Abdelrahman44/autonomous-robot/snapshot00.png

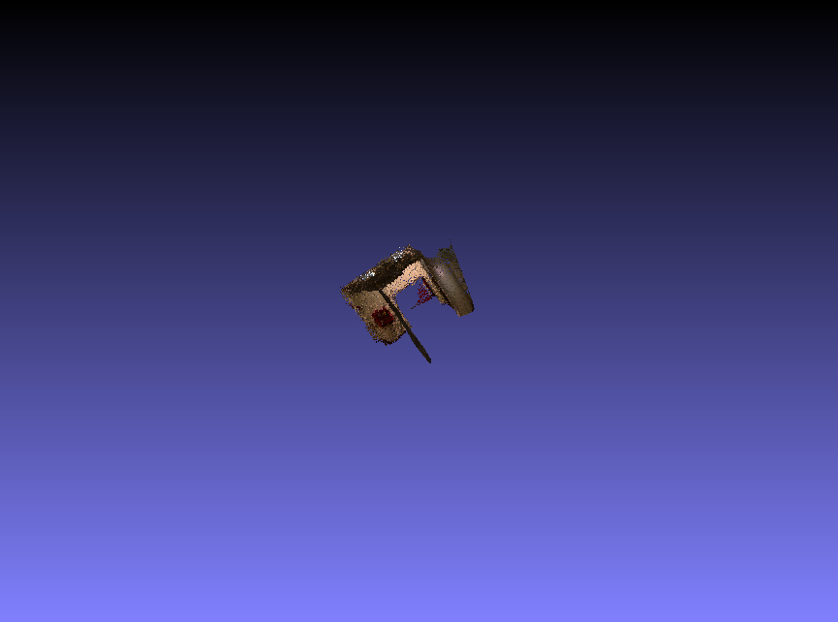
snapshot00.png
