Abdelrahman44/autonomous-robot/snapshot200.png

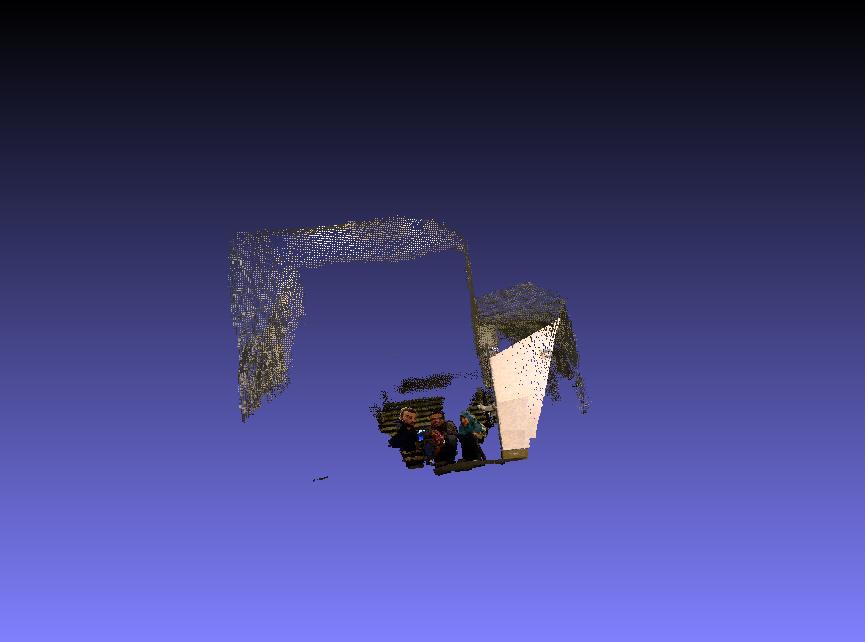
snapshot200.png
