Abdelrahman44/autonomous-robot/README.md

# autonomous-robot

A robot built using ROS to navigate and map the environment using Kinect and ultra sonic sensors. Ardunio codes and integration with ROS are included
