Abdelrahman44/autonomous-robot/Selection_001.png

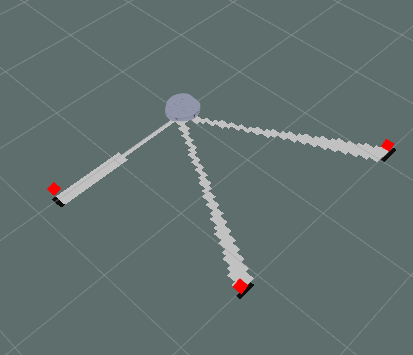
Selection_001.png
