Abdelrahman44/autonomous-robot/Hexabot/meshes/BackCastor.STL

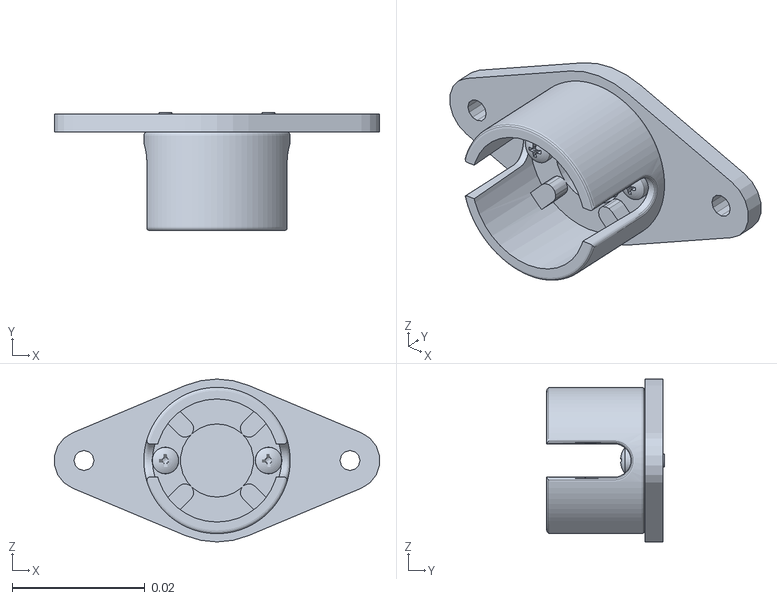
[picture p16: CAD file, 2020-01-17]
Hexabot/meshes/BackCastor.STL
0.0489 x 0.0177 x 0.0245
