Abdelrahman44/autonomous-robot/Hexabot/robots/include/RightWheel.STL

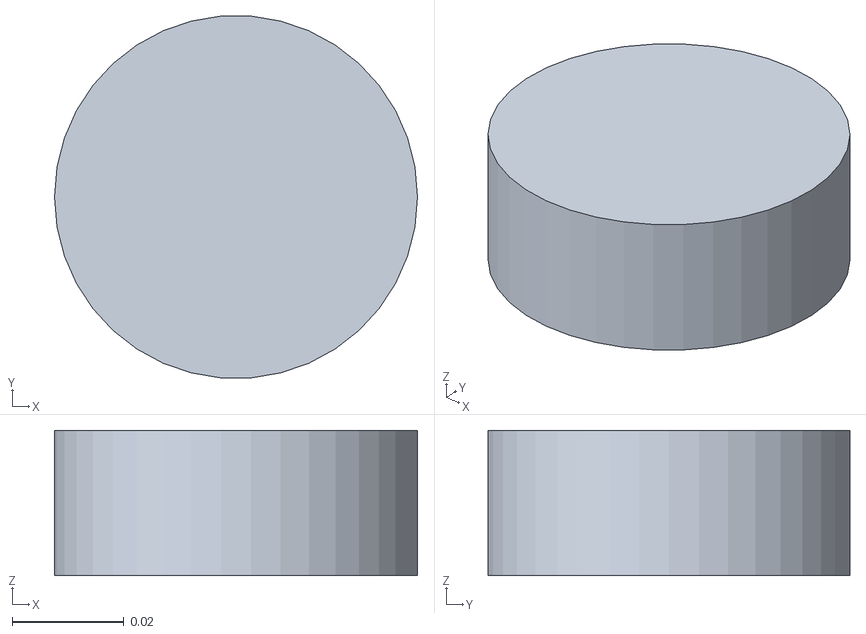
[picture p17: CAD file, 2020-01-17]
Hexabot/robots/include/RightWheel.STL
0.065 x 0.0648 x 0.026
