Abdelrahman44/autonomous-robot/Hexabot/meshes/UltraLeft3.STL

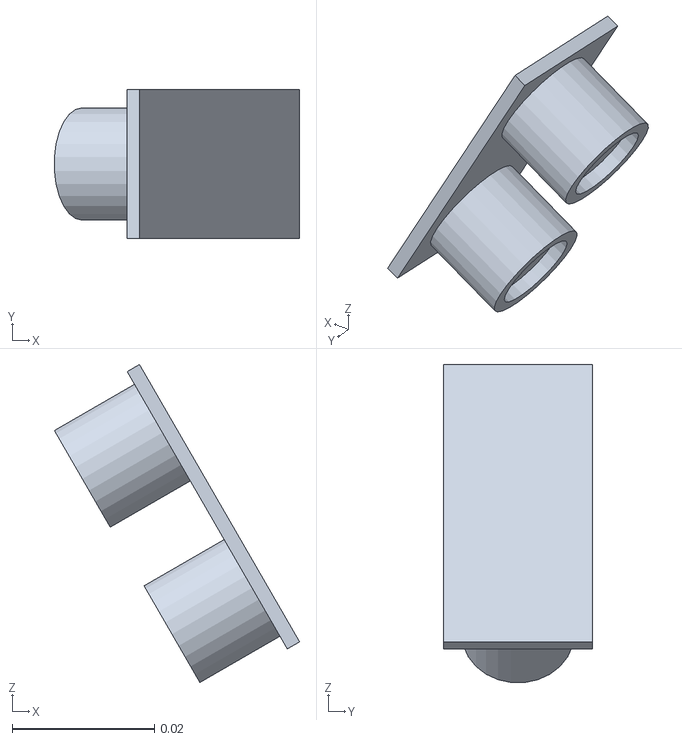
[picture p18: CAD file, 2020-01-17]
Hexabot/meshes/UltraLeft3.STL
0.0345 x 0.021 x 0.0447
