Abdelrahman44/autonomous-robot/Hexabot/meshes/UltraLeft2.STL

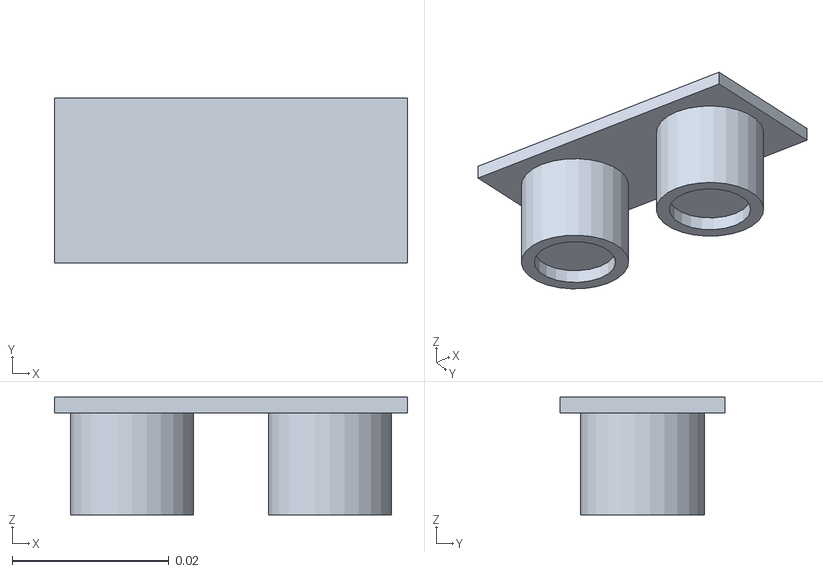
[picture p19: CAD file, 2020-01-17]
Hexabot/meshes/UltraLeft2.STL
0.045 x 0.021 x 0.015
