Abdelrahman44/autonomous-robot/Hexabot/robots/include/base_link.STL

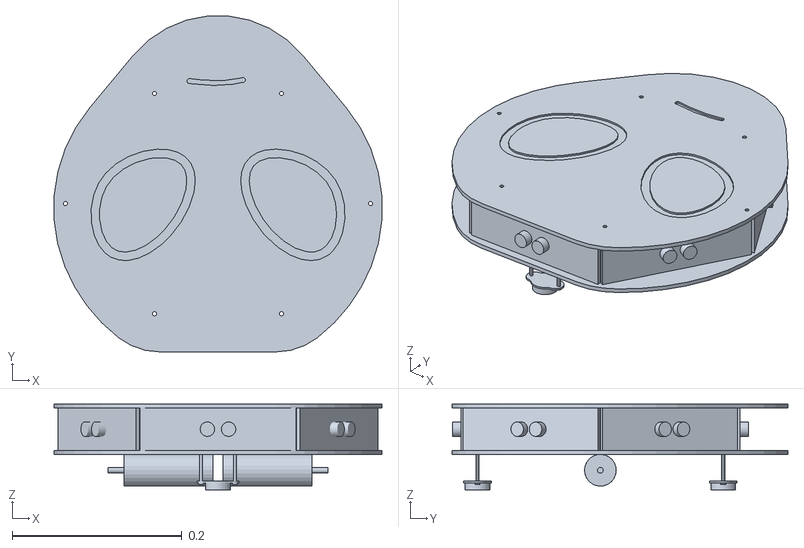
[picture p20: CAD file, 2020-01-17]
Hexabot/robots/include/base_link.STL
0.387 x 0.396 x 0.101
