Abdelrahman44/autonomous-robot/Hexabot/robots/include/CastorBack.STL

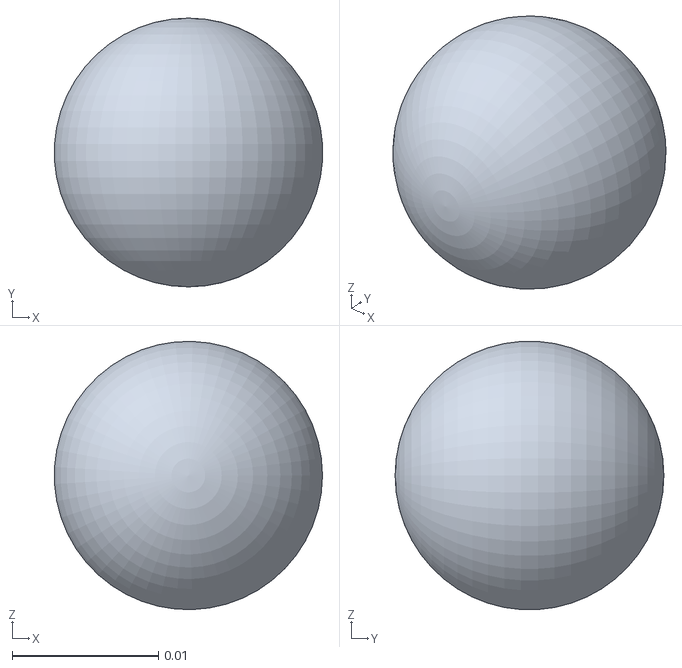
[picture p21: CAD file, 2020-01-17]
Hexabot/robots/include/CastorBack.STL
0.0183 x 0.0184 x 0.0184
