Abdelrahman44/autonomous-robot/Hexabot/meshes/LeftWheel.STL

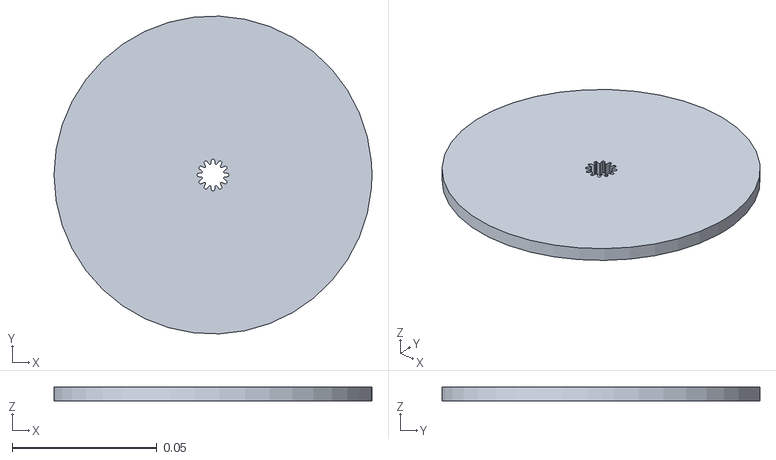
[picture p22: CAD file, 2020-01-17]
Hexabot/meshes/LeftWheel.STL
0.11 x 0.11 x 0.0047
