Abdelrahman44/autonomous-robot/Hexabot/meshes/CastorBallFront.STL

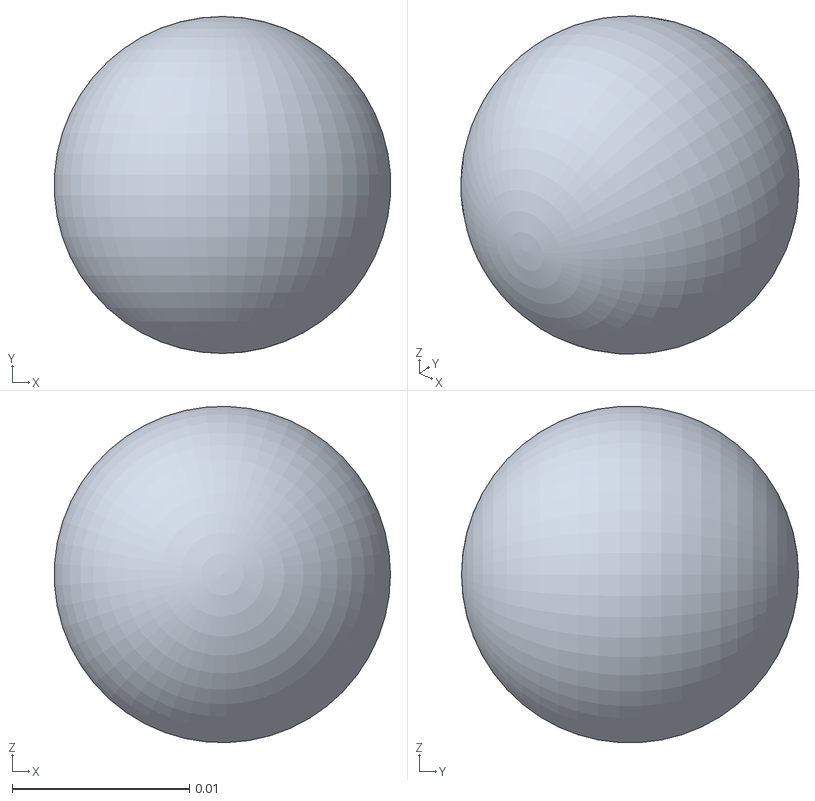
[picture p23: CAD file, 2020-01-17]
Hexabot/meshes/CastorBallFront.STL
0.0189 x 0.019 x 0.019
