Abdelrahman44/autonomous-robot/Hexabot/meshes/base_link.STL

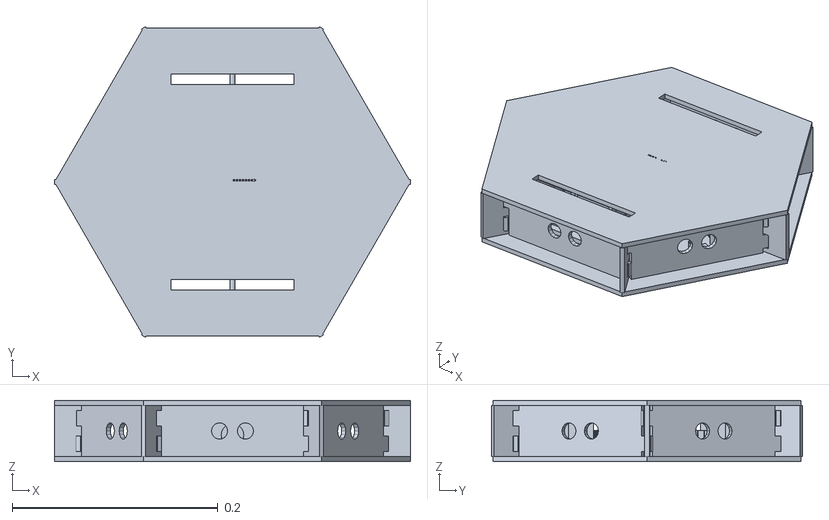
[picture p24: CAD file, 2020-01-17]
Hexabot/meshes/base_link.STL
0.346 x 0.302 x 0.0594
