Abdelrahman44/autonomous-robot/(list of files, cad)

Other CAD files:
Hexabot/robots/include/LeftWheel.STL
Hexabot/meshes/UltraRight3.STL
Hexabot/robots/include/CastorFront.STL
Hexabot/meshes/UltraRight1.STL
Hexabot/meshes/UltraLeft1.STL
Hexabot/meshes/CastorBallBack.STL
Hexabot/meshes/UltraRight2.STL
Hexabot/meshes/RightWheel.STL
Hexabot/meshes/FrontCastor.STL
