Abdelrahman44/autonomous-robot/Hexabot/Parameters.txt

Wheel Dia:
110 mm

Wheel separation:
195 mm
